SeymurD/homemade-cybertruck/Cybertruck Models/models/Chassis Parts/Motor-PlanetaryGear-Encoder.STEP

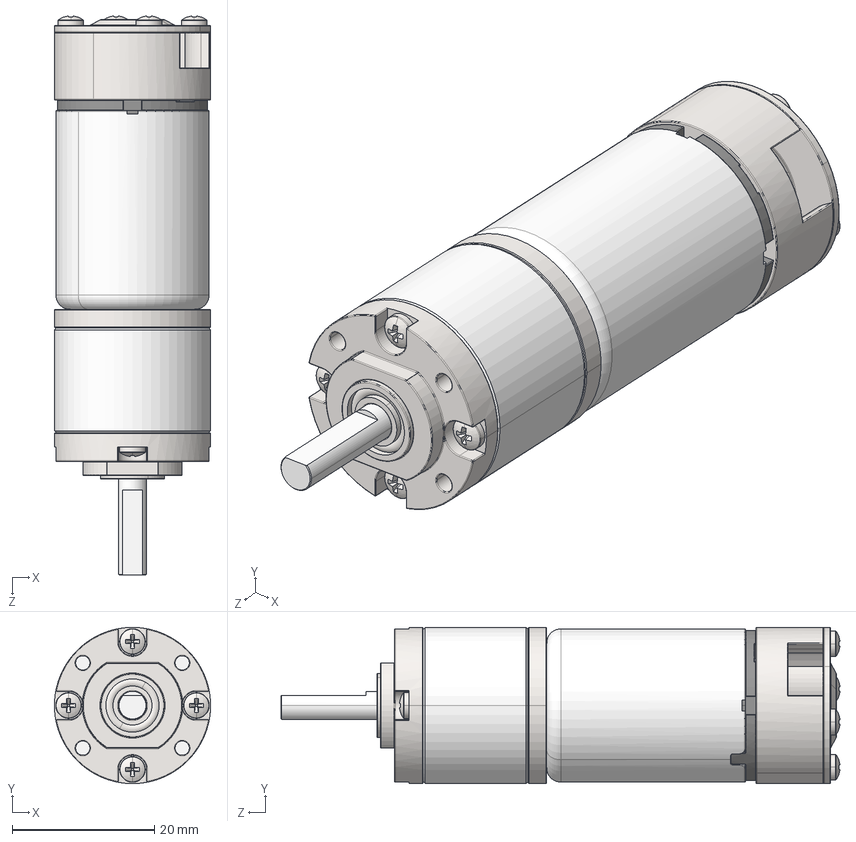
[picture p1: CAD file, 2020-12-03]
Cybertruck Models/models/Chassis Parts/Motor-PlanetaryGear-Encoder.STEP
22.0 x 22.0 x 78.7 mm
Gearbox-Body
Gearbox-TopCap
Gearbox-BotomCap
Gearbox-Shaft
Motor-Body
pan cross head_ai_CR-PHMS 0.073-72x0.75x0.75-N x 4
instrument ball bearing_68_am_AFBMA 12.1.4.1 - 0040-9 - 10,SI,NC,10_68
Motor-Cap
Encoder-Body
Encoder-Cap
pan cross head_ai_CR-PHMS 0.073-72x0.125x0.125-N x 4
